camhan22/Analog-PID-Magnetic-Levitator/(list of files, drawings)

Other design files:
Final Project Design.ms14
